SANCHAIE/mongobox/docs/MangoBox_Handout.docx

ใบงานเวิร์กช็อป

MangoBox — วัดแก๊สเอทิลีน และพิสูจน์ว่าเอทิลีนเร่งการสุก

การประดิษฐ์วงจรบอร์ดเซ็นเซอร์เพื่อดูดซับแก๊สเอทิลีน · ระบบปิด · เหตุ (แก๊ส) → ผล (การสุก)

ชื่อ–สกุล ผู้ทำใบงาน: | ทีม/กลุ่ม:
วันที่: 13 กรกฎาคม 2569 | โรงเรียน: พลูตาหลวงวิทยา

# 1. จุดประสงค์การเรียนรู้

- อธิบายได้ว่าเอทิลีนคืออะไร และเป็น "ตัวเร่ง" การสุกของผลไม้อย่างไร
- ต่อวงจร ESP32-S3 เข้ากับเซ็นเซอร์ SGP30, TCS34725, BME280 และจอ OLED บนบัส I2C ได้
- แยกได้ว่าอะไรคือ "เหตุ" (ระดับเอทิลีน) และอะไรคือ "ผล" (อัตราการสุก)
- ออกแบบการทดลองเปรียบเทียบ 4 กล่อง พิสูจน์ว่าเอทิลีนเร่งการสุกจริง และนำเสนอผลได้
- ใช้กล่องได้ 2 โหมด: METER (คัดผลไม้ใช้จริง) และ LAB (ทดลองพิสูจน์เหตุ–ผล)

# 2. อุปกรณ์ต่อ 1 ชุด

อุปกรณ์ | หน้าที่ | I2C Address
บอร์ด ESP32-S3 N16R8 (DevKitC-1) | ตัวประมวลผล + WiFi/BT | -
SGP30 | เซ็นเซอร์แก๊ส (TVOC + eCO2) | 0x58
TCS34725 | เซ็นเซอร์สีเปลือก (RGB) | 0x29
BME280 | อุณหภูมิ / ความชื้น | 0x76 หรือ 0x77
จอ OLED SSD1306 0.96" | แสดงผลค่าเรียลไทม์ | 0x3C
พัดลม 5V + ทรานซิสเตอร์ | กวนอากาศในกล่อง | -
เบรดบอร์ด + สายจัมเปอร์ | ต่อวงจร | -
กล่อง/ถุงพลาสติกใส | ห้องปิด (chamber) | -

# 3. การต่อวงจร (Wiring)

หลักการสำคัญ: เซ็นเซอร์และจอทุกตัวใช้บัส I2C ร่วมกัน จึงต่อ 4 สายเหมือนกันทุกตัว โดยใช้รางไฟบวก (+) และราง GND (–) บนเบรดบอร์ดช่วย

ขาของเซ็นเซอร์/จอ | ต่อเข้ากับ ESP32 | สี/หมายเหตุ
VCC | 3V3 | ไฟเลี้ยง (แดง)
GND | GND | กราวด์ (ดำ)
SDA | GPIO8 | สายข้อมูล (น้ำเงิน)
SCL | GPIO9 | สายนาฬิกา (เขียว)
พัดลม (สายคุม) | GPIO10 | ผ่านทรานซิสเตอร์เท่านั้น

ดูรายละเอียดจาก "แผนผังการต่อวงจร (wiring_diagram)" ที่แจกคู่กับใบงานนี้

⚠ ข้อควรระวัง

ต่อสายให้เสร็จก่อนเสียบ USB ทุกครั้ง และตรวจว่า VCC/GND ไม่สลับกัน

พัดลมกินไฟมาก ห้ามต่อขาพัดลมกับ GPIO โดยตรง ต้องผ่านทรานซิสเตอร์เสมอ

# 4. สองโหมดในกล่องเดียว (ใช้ปุ่ม BOOT บนบอร์ด — ไม่ต้องต่อปุ่มเพิ่ม)

| โหมด METER (ใช้งานจริง) | โหมด LAB (ทำโครงงาน)
ตอบคำถาม | "มะม่วงลูกนี้กินได้หรือยัง?" | "เอทิลีนเร่งการสุกจริงไหม?"
จอแสดงผล | ความสุกรวม 0–100% + ดิบ/พอดี/งอม | ETHYLENE | RIPE แยกช่อง + อัตราการสุก
การรวมค่า | รวมสี 60% + แก๊ส 40% | ไม่รวม — แยกเหตุกับผลเด็ดขาด
ใช้ตอน | คัดผลไม้ ตรวจก่อนกิน/ก่อนส่ง | ทดลอง 4 กล่อง เก็บข้อมูลข้ามวัน

วิธีใช้ปุ่ม BOOT (ปุ่มสีดำเล็ก ๆ ที่ติดมากับบอร์ดแล้ว)

กดค้าง 2 วินาที = สลับโหมด (จอจะขึ้น SWITCH MODE)

กดสั้น ๆ 1 ครั้ง = บันทึกผลประจำวัน (ใช้เฉพาะโหมด LAB)

ห้ามกดปุ่มนี้ค้างไว้ตอนกด RESET หรือตอนเสียบสาย USB (บอร์ดจะเข้าโหมดอัปโหลด)

วางบอร์ดไว้นอกกล่อง เพื่อกดปุ่มได้โดยไม่ต้องเปิดฝา (เปิดฝา = แก๊สหนีหมด)

# 5. บันได 10 ขั้น — ทำทีละขั้น ติ๊กเมื่อผ่าน

อย่าข้ามขั้น! ถ้าขั้นก่อนหน้ายังไม่ผ่าน ขั้นถัดไปจะพังแน่นอน และหาสาเหตุยากขึ้นเรื่อย ๆ

✓ | ขั้น | สิ่งที่ได้เรียนรู้ | ผ่านเมื่อ...
| 1. RGB LED + Serial | setup / loop / Serial | ไฟ RGB (GPIO48) ไล่สี + Serial มีข้อความ
| 2. I2C Scan | บัส I2C, address, การเช็ก ACK | เจอครบ 4 ตัว: 0x29 0x3C 0x58 0x76 (นิ่ง 20/20)
| 3. BME280 | ไลบรารี, อ่านค่าเซ็นเซอร์ | เห็นอุณหภูมิ/ความชื้น
| 4. OLED | วาดบนจอ, พิกัด x/y | จอโชว์อุณหภูมิตัวใหญ่
| 5. เซ็นเซอร์สี | RGB → Hue, เขียนฟังก์ชันเอง | จ่อใบไม้ = %ต่ำ / ของเหลือง = %สูง
| 6. เซ็นเซอร์แก๊ส ★ | TVOC, อุ่นเครื่อง, ชดเชยความชื้น | ปิดกล่องมีกล้วย → ตัวเลขไต่ขึ้น!
| 7. พัดลม | ทรานซิสเตอร์เป็นสวิตช์ | พัดลมหมุน 3 วิ หยุด 3 วิ
| 8. METER ★ | ถ่วงน้ำหนัก, ตัดสินใจจากข้อมูล | เครื่องวัดความสุกใช้ได้จริง
| 9. โหมด LAB | ตัวแปรต้น–ตาม, บันทึกข้ามวัน | แยกเหตุ-ผล + กดปุ่มบันทึกได้
| 10. WiFi Dashboard | web server, JSON | เปิดดูค่าบนมือถือได้

★ = ขั้นที่ห้ามข้ามเด็ดขาด

STEP 6 (แก๊ส) — เป็นขั้นเดียวที่เรา "เห็นกับตา" ว่าผลไม้ปล่อยแก๊สจริง ถ้าข้าม โปรเจกต์จะเหลือแค่ "วัดสี" ซึ่งไม่ตรงโจทย์

STEP 8 (METER) — เป็นขั้นที่ทุกอย่างมารวมกันเป็นเครื่องมือใช้จริง

ทุกไฟล์โค้ดมีหัวข้อ "ลองเล่นดู" และ "คำถาม" อยู่ท้ายไฟล์ — ตรงนั้นคือจุดที่เราจะเข้าใจจริง ไม่ใช่ตอนก๊อปโค้ด

# 6. ขั้นตอนการทดลอง

1. ต่อวงจรตามตารางข้อ 3 และตรวจสอบสายให้เรียบร้อย
2. เปิด Arduino IDE เลือกบอร์ด ESP32S3 Dev Module → เปิด USB CDC On Boot: Enabled แล้วเลือกพอร์ตให้ถูกต้อง
3. เปิดไฟล์ mango_ripeness_esp32.ino แก้บรรทัด #define BOX_ID ให้ตรงกับกล่องของกลุ่ม (A/B/C/D) แล้วกด Upload
4. เปิด Serial Monitor (115200) ตรวจว่าเจอเซ็นเซอร์ครบ — ถ้าเจอบ้างไม่เจอบ้าง = สายหลวม ให้รัน tools/i2c_stability เช็ก 20 รอบ

PART A — วันนี้ในเวิร์กช็อป

5. โหมด METER: เอาเซ็นเซอร์สีจ่อมะม่วงหลาย ๆ ลูก อ่านคะแนนความสุก แล้วลองคัดว่าลูกไหน ดิบ/พอดี/งอม
6. จัดกล่องตามที่ได้รับมอบหมาย ปิดฝา เปิดพัดลม รอ SGP30 อุ่นเครื่อง (15 วินาทีแรกค่าจะขึ้น 0 ppb เป็นเรื่องปกติ)
7. กดปุ่ม BOOT ค้าง 2 วินาที เพื่อสลับไปโหมด LAB
8. บันทึกค่า TVOC ทุก 5 นาที ลงตาราง 7.1 (วันนี้จะเห็น TVOC พุ่งขึ้นภายใน 10–20 นาที)

PART B — ต่อเนื่อง 3–5 วันก่อนแข่ง

9. กดปุ่ม BOOT สั้น ๆ 1 ครั้ง = บันทึกผลประจำวัน (ทำวันละครั้ง เวลาเดิม ต่อเนื่อง 3–5 วัน)
10. วันสุดท้าย พิมพ์ตัวอักษร p ใน Serial Monitor เพื่อดูตารางสรุปทั้งหมด แล้วกรอกลงตาราง 7.2

กล่องของแต่ละกลุ่ม (เขียนวงกลมรอบกล่องของกลุ่มตัวเอง)

A = มะม่วง + กล้วยสุกงอม (เพิ่มเอทิลีน → คาดว่าสุกเร็วที่สุด)

B = มะม่วงอย่างเดียว (control / ตัวเทียบ)

C = มะม่วง + ด่างทับทิม (ดูดซับเอทิลีน → คาดว่าสุกช้าที่สุด)

D = กล่องเปล่า (baseline ของเซ็นเซอร์)

# 7. ตารางบันทึกผล

7.1 วันนี้: ดู "เหตุ" — เอทิลีนพุ่งขึ้นไหม? (บันทึกทุก 5 นาที)

กล่องของกลุ่ม: ............ สิ่งที่ใส่ในกล่อง: ..............................................................

ครั้งที่ | เวลา | อุณหภูมิ (°C) | ความชื้น (%) | TVOC (ppb) | ความสุกจากสี (%)
1
2
3
4
5
6

สังเกต: วันนี้ "สี" จะยังแทบไม่เปลี่ยน — เพราะการสุกต้องใช้เวลาหลายวัน นั่นคือเหตุผลที่ต้องเก็บข้อมูลต่อ

7.2 หลายวัน: ดู "ผล" — กล่องไหนสุกเร็วกว่ากัน? (กดปุ่ม BOOT วันละครั้ง)

วันที่ | กล่อง A (กล้วย) | กล่อง B (control) | กล่อง C (ดูดซับ) | กล่อง D (เปล่า)
TVOC / ความสุก (%) | TVOC / ความสุก | TVOC / ความสุก | TVOC / ความสุก | TVOC / ความสุก
วัน 1
วัน 2
วัน 3
วัน 4
วัน 5

7.3 สรุป: อัตราการสุก (%/วัน)

อัตราการสุก = (ความสุกวันสุดท้าย − ความสุกวันแรก) ÷ จำนวนวันที่ผ่านไป

กล่อง | TVOC เฉลี่ย (ppb) | อัตราการสุก (%/วัน) | เรียงลำดับการสุก (เร็ว→ช้า)
A (กล้วยสุกงอม)
B (control)
C (ด่างทับทิม)
D (กล่องเปล่า)

# 8. วาดกราฟความสัมพันธ์ (เหตุ → ผล)

เอาข้อมูลจากตาราง 7.3 มาลงจุด แกนนอน = TVOC (ppb), แกนตั้ง = อัตราการสุก แล้วเขียนชื่อกล่อง (A/B/C/D) กำกับแต่ละจุด

อัตราการสุก (%/วัน) ↑

TVOC (ppb) — พร็อกซี่ของเอทิลีน →

ถ้าจุดเรียงจากล่างซ้ายไปบนขวา = แก๊สยิ่งสูง การสุกยิ่งเร็ว → สมมติฐานเป็นจริง!

# 9. คำถามท้ายการทดลอง

1) ในระบบนี้ อะไรคือ "เหตุ" และอะไรคือ "ผล"? เราวัดแต่ละอย่างด้วยเซ็นเซอร์ตัวไหน?
2) ทำไมเราจึง "ไม่" เอาค่าแก๊สกับค่าสีมารวมเป็นคะแนนเดียวกัน?
3) กล่อง D (เปล่า) ไม่มีผลไม้เลย แล้วเรามีไว้ทำไม?
4) ด่างทับทิมทำให้เอทิลีนลดลงจริงไหม? ดูจากตัวเลขใด และการสุกช้าลงตามไปด้วยหรือไม่?

# 10. สรุปผลและข้อจำกัด

สมมติฐานของเรา: กล่องที่มีเอทิลีนสูงกว่า จะสุกเร็วกว่า

ผลการทดลองสนับสนุนสมมติฐานหรือไม่ (วงกลม): สนับสนุน / ไม่สนับสนุน / ยังสรุปไม่ได้

เพราะ ............................................................................................................................

ข้อจำกัดที่ต้องเขียนในรายงาน (กรรมการชอบทีมที่บอกข้อจำกัดตัวเองได้)

SGP30 วัด "สารระเหยรวม (TVOC)" ไม่ใช่เอทิลีนบริสุทธิ์ จึงเป็นเพียงตัวแทน (พร็อกซี่) ของเอทิลีน

eCO2 ที่เซ็นเซอร์ให้มา เป็นค่า "ประมาณ" ไม่ใช่ CO₂ ที่วัดจริง — ห้ามเคลมเกินในรายงาน

สิ่งที่เชื่อถือได้คือการ "เปรียบเทียบระหว่างกล่อง" ไม่ใช่ตัวเลขสัมบูรณ์

ตัวแปรอื่นที่อาจรบกวน: อุณหภูมิ ความชื้น ความสุกเริ่มต้นของมะม่วงแต่ละลูก

# 11. ต่อยอด: เอาผลจาก LAB ไปคาลิเบรต METER

นี่คือจุดที่ทำให้โปรเจกต์นี้โตกว่างานประกวดทั่วไป — เราไม่ได้ "เดา" เกณฑ์ แต่ทดลองหาเกณฑ์เอง แล้วเอาไปทำเป็นเครื่องมือใช้จริง

ค่าในโค้ด | ความหมาย | ค่าเริ่มต้น | ค่าที่วัดได้จริง
HUE_RAW | สีตอนดิบ (0%) | 120°
HUE_RIPE | สีตอนสุกพอดี (100%) | 55°
TVOC_BASE | TVOC อากาศสะอาด (ppb) | 0
TVOC_HIGH | TVOC ตอนสุกเต็มที่ (ppb) | 500

วิธีทำ: ดูจากข้อมูลหลายวันว่ามะม่วงที่ "สุกพอดีกินได้" มีค่า Hue เท่าไร แล้วนำไปแก้ค่าในไฟล์ .ino จากนั้นโหมด METER จะแม่นขึ้นสำหรับมะม่วงพันธุ์นี้โดยเฉพาะ

# 12. ไล่บั๊ก: เจอปัญหาแบบนี้ ทำยังไง

ตารางนี้มาจากการทดสอบจริง — ปัญหาพวกนี้จะเจอแน่นอน ไม่ใช่เรื่องแปลก

อาการ | สาเหตุที่เป็นไปได้ | วิธีแก้
Serial Monitor เงียบสนิท ไม่มีข้อความเลย | USB CDC On Boot ยังไม่เปิด | Tools → USB CDC On Boot → Enabled แล้วอัปโหลดใหม่
ไฟ RGB ไม่ติด | ขาผิด (บอร์ดนี้ใช้ GPIO48 ไม่ใช่ 38) | เปลี่ยนเป็น 48 และใช้ neopixelWrite() ไม่ใช่ digitalWrite()
I2C Scan ไม่เจออะไรเลย (0 ตัว) | SDA/SCL สลับกัน หรือไม่มี ไฟเลี้ยง | เช็ก SDA→GPIO8, SCL→GPIO9 และ VCC→3V3, GND→GND
เจอบ้าง ไม่เจอบ้าง สลับไปมา | สายหลวม (ปัญหาอันดับ 1!) | กดสายให้แน่น ใช้สายสั้นลง ลดจุดต่อ + Wire.setClock(50000)
ไม่เจอจอ OLED แต่สายต่อถูกแล้ว | จอบางรุ่นใช้ address 0x3D ไม่ใช่ 0x3C | ดูผลสแกนว่ามี 0x3D ไหม แล้วแก้ในโค้ด
ไม่เจอ SGP30 (0x58) | บางโมดูลต้องการไฟ 5V ไม่ใช่ 3V3 | ย้าย VCC ของ SGP30 ไปที่ 5V
โปรแกรมบอก OK แต่จอดำสนิท | begin() ของไลบรารีโกหก! | ใช้ i2cAlive() เช็ก ACK เอง ก่อนเรียก begin()
Adafruit_Sensor.h not found | ชื่อไลบรารีไม่ตรงชื่อไฟล์ | ค้นว่า "Adafruit Unified Sensor" ใน Library Manager
TVOC ค้างที่ 0 ppb | SGP30 กำลังอุ่นเครื่อง | รอ 15 วินาที (ปกติ) ถ้าเกินนั้น = เช็กสาย
TVOC สูงผิดปกติ ทั้งที่ไม่มีผลไม้ | ฟลักซ์บัดกรียังไม่ล้าง หรือยังไม่ burn-in | ล้างฟลักซ์ด้วย IPA + เสียบไฟทิ้งไว้ให้นานที่สุด

บทเรียนวิศวกรรมที่สำคัญที่สุด

"อย่าเชื่อสิ่งที่คนอื่นเขียนมา — ตรวจสอบเอง"

เราพบว่า SSD1306.begin() คืนค่า "สำเร็จ" ทั้งที่ไม่ได้ต่อจอเลย! เพราะมันไม่ได้เช็กว่ามีใครตอบกลับมาจริงไหม

วิศวกรที่ดีจะไม่เชื่อคำตอบง่าย ๆ แต่จะหาวิธีตรวจสอบที่เชื่อถือได้ (ในที่นี้คือเช็ก I2C ACK เอง)

ถ้ากลุ่มไหนเซ็นเซอร์เสีย ไม่ต้องกังวล — ใช้ MOCK MODE (step00_mock) เรียนต่อได้ทันที

หมายเหตุด้านความปลอดภัย: ด่างทับทิม (KMnO₄) เป็นสารออกซิไดซ์ ควรให้ครูผู้ดูแลเป็นผู้หยิบจับ และล้างมือหลังการทดลองทุกครั้ง
