SANCHAIE/mongobox/docs/MangoBox_Workshop_Slides.pptx

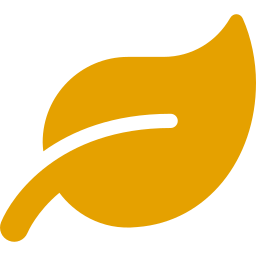
[picture p1: figure]

WORKSHOP · ESP32 · 6 ชั่วโมง

MangoBox

วัดแก๊สเอทิลีน และพิสูจน์ว่าเอทิลีนเร่งการสุกของผลไม้

เครื่องวัดความสุกใช้จริง (METER) + ชุดทดลองพิสูจน์เหตุ–ผล (LAB) ในบอร์ดเดียว

วิทยากร ผศ.ดร.สัญชัย เอียดปราบ (ESCE, คณะวิศวกรรมศาสตร์ ม.บูรพา)

ผู้เข้าอบรม ครูและนักเรียน โรงเรียนพลูตาหลวงวิทยา (ทีมแพรกษาวิชาการ ครั้งที่ 31)

วันที่ วันจันทร์ที่ 13 กรกฎาคม 2569 ณ คณะวิศวกรรมศาสตร์ มหาวิทยาลัยบูรพา

## Slide 2

ภาพรวม

วันนี้เราจะได้สร้างและเข้าใจอะไรบ้าง

ประกอบ "กล่องวัดเอทิลีน"

ระบบปิดที่วัดระดับแก๊สเอทิลีนได้จริง ด้วย ESP32-S3 + เซ็นเซอร์ 3 ตัว

เข้าใจ "เอทิลีน"

ฮอร์โมนแก๊สที่ "เร่ง" ให้ผลไม้สุก และวิธีวัดด้วยเซ็นเซอร์แก๊ส SGP30 (TVOC)

ใช้จริง + ทำโครงงาน

โหมด METER คัดผลไม้ได้ทันที · โหมด LAB ทดลอง 4 กล่องพิสูจน์เหตุ–ผล

เก็บข้อมูล + นำเสนอ

บันทึกหลายวัน พล็อตกราฟความสัมพันธ์ พร้อมไปแข่งแพรกษาวิชาการ

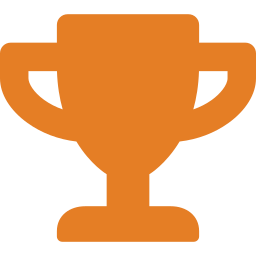
[picture p2: figure]

## Slide 3

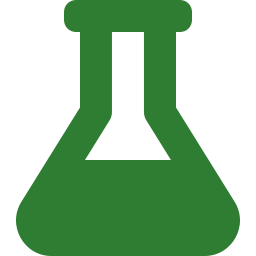
[picture p3: figure]

วิทยาศาสตร์เบื้องหลัง

เอทิลีน — "ฮอร์โมนการสุก" ของผลไม้

เกิดอะไรขึ้นเมื่อผลไม้สุก?

- ผลไม้ปล่อยแก๊ส เอทิลีน (C₂H₄) ออกมาเอง
- เอทิลีนเป็นตัวเร่ง/สั่งให้ผลไม้สุกต่อ — ยิ่งสุกยิ่งปล่อยมาก (autocatalytic)
- พร้อมกันนั้น แป้ง → น้ำตาล, เปลือกเปลี่ยนสี เขียว → เหลือง, เนื้อนิ่มลง
- "ผลไม้ 1 ลูกสุก ทำให้ลูกข้าง ๆ สุกตาม" คือเอทิลีนกำลังทำงาน

เราวัดอะไรได้บ้าง?

กลิ่น/แก๊สที่ระเหย

→ SGP30 (TVOC, ppb)

สีเปลือกที่เปลี่ยน

→ เซ็นเซอร์สี (TCS34725)

อุณหภูมิ/ความชื้น

→ BME280 (ตัวแปรร่วม)

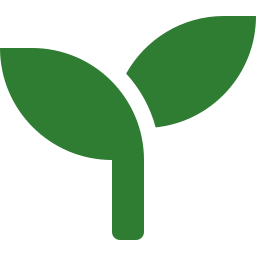
[picture p4: figure]
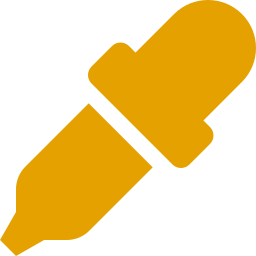
[picture p5: figure]
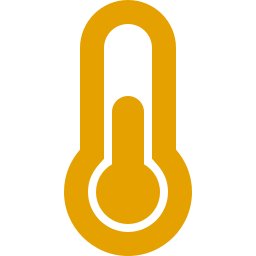
[picture p6: figure]

## Slide 4

หัวใจของการทดลอง

ทำไมต้องเป็น "ระบบปิด" (Closed Chamber)?

ปัญหา

- เอทิลีนจากมะม่วง 1 ลูกมีปริมาณน้อยมาก
- ถ้าวัดในที่โล่ง แก๊สจะฟุ้งหายไปทันที
- เซ็นเซอร์แทบจับความเปลี่ยนแปลงไม่ได้

วิธีแก้: ขังแก๊สให้เข้มข้นขึ้น

ขังในกล่อง/ถุงพลาสติกใส

แก๊สสะสมเข้มข้นขึ้นเรื่อย ๆ วัดค่าความต่างได้ชัด

ใส่พัดลมจิ๋วกวนอากาศ

ค่าเซ็นเซอร์นิ่งและสม่ำเสมอทั่วทั้งกล่อง

เทียบกับ "กล่องเปล่า" (control)

เห็นชัดว่าค่าที่สูงขึ้นมาจากผลไม้จริง

เพิ่มสารดูดซับเอทิลีน (KMnO₄)

ทดลองได้ว่าตัวดูดซับช่วยชะลอการสุกจริงไหม

1

2

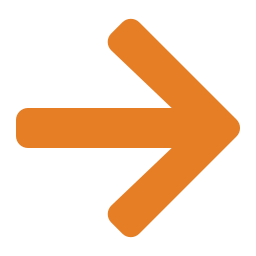
[picture p7: figure]

3

4

## Slide 5

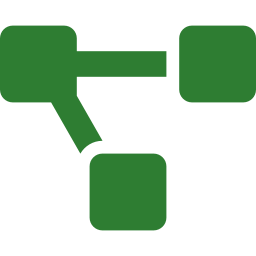
[picture p8: figure]

สถาปัตยกรรมระบบ

ภาพรวมระบบ: เซ็นเซอร์ → สมอง → แสดงผล

SGP30

แก๊ส TVOC (ppb)

จอ OLED

แสดงค่า real-time

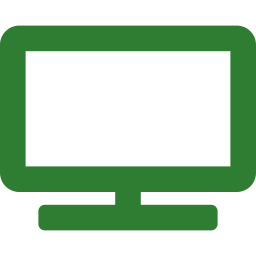
[picture p9: figure]

ESP32-S3

อ่านค่า · คำนวณ · WiFi

TCS34725

สีเปลือก

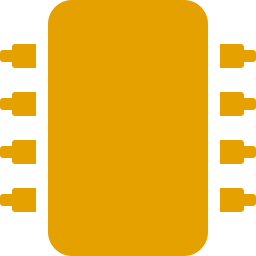
[picture p10: figure]

Serial Plotter

กราฟ + บันทึก CSV

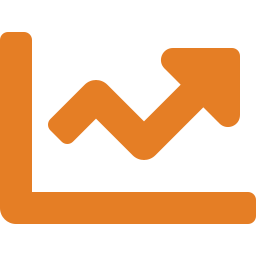
[picture p11: figure]

BME280

อุณหภูมิ/ชื้น

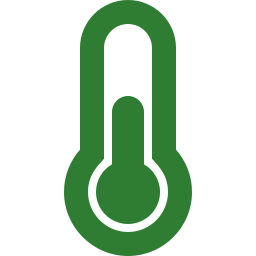
[picture p12: figure]

Dashboard WiFi

ดูจากมือถือ

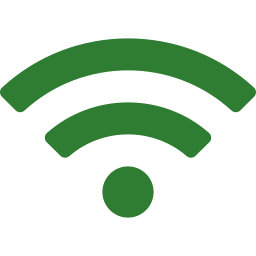
[picture p13: figure]

I2C bus

## Slide 6

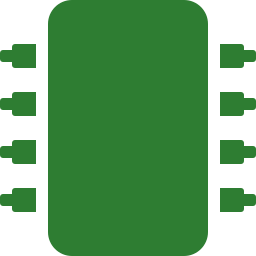
[picture p14: figure]

อุปกรณ์

ทำความรู้จักเซ็นเซอร์ในกล่อง

SGP30

แก๊ส TVOC

วัดสารระเหยรวม (พร็อกซี่ของเอทิลีน) เป็น ppb + eCO2

TCS34725

เซ็นเซอร์สี

อ่านค่า RGB ของเปลือก — ช่องทางที่ชัวร์ที่สุด

I2C 0x58

I2C 0x29

BME280

อุณหภูมิ/ชื้น

ใช้ชดเชยค่าแก๊สให้แม่นขึ้น + เป็นตัวแปรร่วม

OLED 0.96"

จอแสดงผล

SSD1306 แสดงค่าและแถบความสุกแบบเรียลไทม์

I2C 0x76

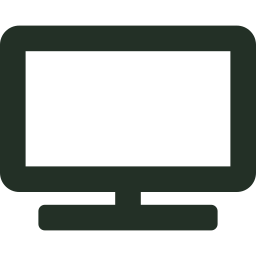
[picture p15: figure]

I2C 0x3C

## Slide 7

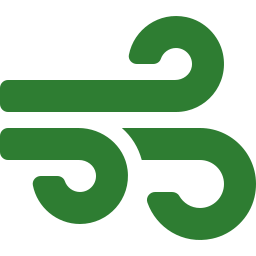
[picture p16: figure]

เจาะลึกเซ็นเซอร์แก๊ส

SGP30 กับค่า "TVOC (ppb)" ที่ต้องเข้าใจ

SGP30 ให้ค่าอะไร

- TVOC (ppb)
  - ปริมาณสารระเหยรวมในอากาศ — อากาศสะอาด ≈ 0 ppb
  - ผลไม้สุกปล่อยสารระเหยมาก → ตัวเลขยิ่งสูง
- eCO2 (ppm) — ของแถม
  - เป็นค่า "ประมาณ" จากไฮโดรเจน ไม่ใช่ CO₂ จริง

ข้อควรระวัง (สำคัญมาก)

- อุ่นเครื่อง 15 วินาที
  - ช่วงแรกจะขึ้น 0 ppb เสมอ — เป็นเรื่องปกติ
- ต้องมี Baseline ถึงจะแม่น
  - โปรแกรมเก็บ/คืนค่าให้อัตโนมัติ (ทุก 1 ชม.)
  - ครั้งแรกควรเสียบทิ้งไว้ ~12 ชม. (burn-in)

## Slide 8

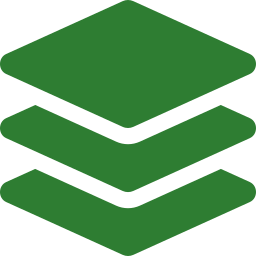
[picture p17: figure]

หัวใจของโปรเจกต์

แยก "เหตุ" ออกจาก "ผล" — ห้ามรวมกัน!

เราจะพิสูจน์ว่า เอทิลีน (เหตุ) เป็นตัวเร่งการสุก (ผล) จึงต้องวัดสองอย่างนี้แยกกันเป็นคนละค่า

เหตุ

ตัวแปรต้น

- ระดับแก๊สเอทิลีน
- วัดด้วย SGP30 → TVOC (ppb)
- ยิ่งมีเอทิลีนมาก ค่ายิ่งสูง

ผล

ตัวแปรตาม

- อัตราการสุก (%/วัน)
- วัดด้วย TCS34725 → สีเปลี่ยนเร็วแค่ไหน
- ไม่ใช่ "ความสุก ณ จุดเดียว"

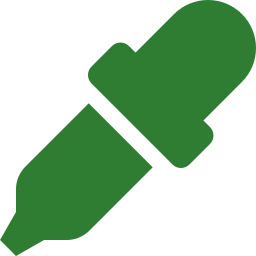
[picture p18: figure]

เร่งให้เกิด

ถ้าเอาสีกับแก๊สมารวมเป็นคะแนนเดียว = เอา "เหตุ" ปนกับ "ผล" แล้วจะพิสูจน์ความสัมพันธ์ไม่ได้เลย

## Slide 9

หนึ่งกล่อง สองการใช้งาน

โหมด METER (ใช้จริง) และโหมด LAB (โครงงาน)

เซ็นเซอร์ชุดเดียวกัน ข้อมูลชุดเดียวกัน — ต่างกันแค่ "จะเอาไปตอบคำถามอะไร"

"มะม่วงลูกนี้กินได้หรือยัง?"

- รวมสี (60%) + แก๊ส (40%) เป็นคะแนนเดียว
- จอโชว์: ความสุก 0–100% + ดิบ / พอดี / งอม
- ใช้คัดผลไม้ ตรวจก่อนกิน / ก่อนส่งขาย

METER

เอาไปใช้จริง

"เอทิลีนเร่งการสุกจริงไหม?"

- แยกเหตุ (เอทิลีน) กับ ผล (การสุก) — ไม่รวมกัน
- จอโชว์: ETHYLENE | RIPE + อัตราการสุก
- ใช้ทดลอง 4 กล่อง เก็บข้อมูลข้ามวัน

LAB

ทำโครงงาน

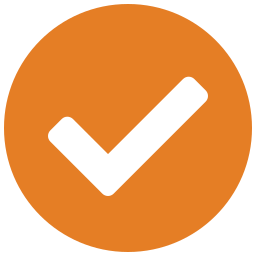
[picture p19: figure]
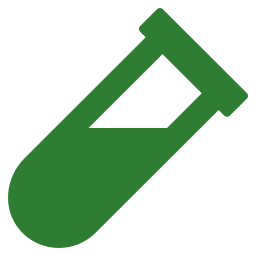
[picture p20: figure]

สลับโหมด: กดปุ่ม BOOT ค้าง 2 วินาที (ปุ่มนี้มีอยู่บนบอร์ดแล้ว ไม่ต้องต่อเพิ่ม) · CSV ส่งออกครบทุกคอลัมน์เสมอ ไม่ว่าอยู่โหมดไหน

## Slide 10

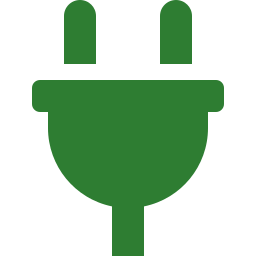
[picture p21: figure]

การเชื่อมต่อ

I2C: สายสองเส้น ใช้ร่วมกันทุกตัว

ทำไม I2C สะดวก

- ใช้แค่ 2 สายข้อมูล: SDA และ SCL
- อุปกรณ์ทุกตัวต่อขนานบนสายเดียวกัน
- แยกกันด้วย "ที่อยู่ (address)" ที่ไม่ซ้ำ
- เพิ่มเซ็นเซอร์ได้ง่าย ไม่ต้องเดินสายใหม่
- ESP32-S3: SDA = GPIO8, SCL = GPIO9

ที่อยู่ (address) ของแต่ละตัว

อุปกรณ์ | หน้าที่ | Address
TCS34725 | สี | 0x29
OLED | จอ | 0x3C
SGP30 | แก๊ส | 0x58
BME280 | อุณหภูมิ/ชื้น | 0x76/0x77

ถ้าตัวไหนหาไม่เจอ ใช้สเก็ตช์ i2c_scanner เช็กสายได้

## Slide 11

ลงมือต่อวงจร

การต่อสาย: ราง (+)/(–) และบัส I2C

SGP30

TCS

BME

ตารางต่อสาย (สรุป)

ขาเซ็นเซอร์ | → ESP32
VCC | 3V3
GND | GND
SDA | GPIO8
SCL | GPIO9
พัดลม (คุม) | GPIO10*

* พัดลมต่อผ่านทรานซิสเตอร์ ไม่ต่อกับ GPIO ตรง ๆ

ESP32-S3

3V3

GND

SDA (8)

SCL (9)

เซ็นเซอร์ทุกตัวต่อ 4 สายเหมือนกัน: VCC→3V3, GND→GND, SDA→GPIO8, SCL→GPIO9

## Slide 12

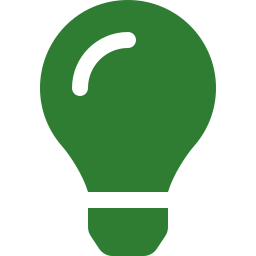
[picture p22: figure]

จากการทดสอบจริง

5 กับดักที่จะเจอแน่นอน — รู้ไว้ก่อน

ทั้งหมดนี้เจอจริงตอนทดสอบ ไม่ใช่ทฤษฎี — เตรียมใจไว้ จะไม่เสียเวลาหน้างาน

USB CDC On Boot = Enabled

ถ้าไม่เปิด → Serial Monitor เงียบสนิท
(เจอบ่อยสุด นักเรียนจะนึกว่าโค้ดพัง)

1

RGB LED อยู่ GPIO48 ไม่ใช่ 38

บอร์ดโคลนย้ายขา และต้องใช้
neopixelWrite() ไม่ใช่ digitalWrite()

2

อย่าเชื่อ begin() — โกหกได้!

SSD1306.begin() คืน true ทั้งที่ไม่ได้ต่อจอ
→ ต้องเช็ก I2C ACK เอง

3

ชื่อไลบรารี ≠ ชื่อไฟล์ .h

Adafruit_Sensor.h ต้องค้นว่า
"Adafruit Unified Sensor"

4

สายหลวม = ปัญหาอันดับ 1

อาการ: เจอบ้างไม่เจอบ้าง
→ Wire.setClock(50000) ช่วยได้เยอะ

บทเรียนวิศวกรรมที่สำคัญที่สุดของวันนี้

"อย่าเชื่อสิ่งที่คนอื่นเขียนมา — ตรวจสอบเอง"
ไลบรารีบอกว่า OK ไม่ได้แปลว่ามันทำงานจริง — วิศวกรที่ดีตรวจสอบด้วยตัวเองเสมอ

5

## Slide 13

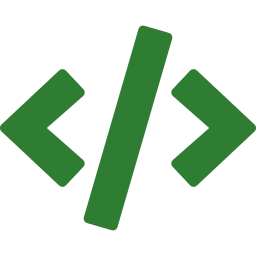
[picture p23: figure]

วิธีเรียนวันนี้

สร้างทีละชั้น — ไม่ใช่แจกโค้ดก้อนเดียว

แต่ละขั้นเพิ่มของใหม่ทีละอย่าง ทดสอบให้ผ่านก่อน แล้วค่อยไปขั้นถัดไป

Blink

บอร์ดไหว

1

I2C Scan

เจอเซ็นเซอร์

2

BME280

อุณหภูมิ/ชื้น

3

OLED

มีจอแล้ว

4

สี

→ %ความสุก

5

แก๊ส

เห็นเอทิลีนพุ่ง!

6

พัดลม

สั่งงานจริง

7

METER

รวมร่าง

8

LAB

แยกเหตุ-ผล

9

WiFi

ดูบนมือถือ

10

ห้ามข้าม STEP 6 — เป็นขั้นเดียวที่นักเรียน "เห็นกับตา" ว่าผลไม้ปล่อยแก๊สจริง · ทุกไฟล์มี "ลองเล่นดู" + คำถามท้ายโค้ด

## Slide 14

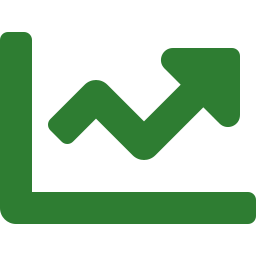
[picture p24: figure]

หัวใจของอัลกอริทึม

วัด "อัตราการสุก" ไม่ใช่ความสุก ณ จุดเดียว

อัตราการสุก (%/วัน) = ความสุกที่เพิ่มขึ้น (จากสี) ÷ จำนวนวันที่ผ่านไป

ความสุกจากสี (ใช้สีล้วน ๆ)

- แปลง RGB → Hue (องศาสี)
- เขียว (~120°) = ดิบ 0%
- เหลือง (~55°) = สุก 100%
- ไม่เอาค่าแก๊สมาปน เพราะแก๊สคือ "เหตุ"

สิ่งที่เราต้องการเห็น

ระดับเอทิลีน →

A มีเอทิลีนสูงสุด → สุกเร็วสุด | C ถูกดูดซับ → สุกช้าสุด

A

B

อัตราการสุก

C

## Slide 15

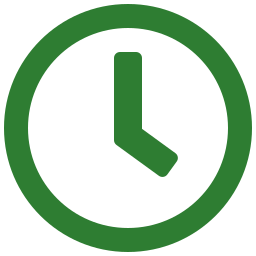
[picture p25: figure]

แผนการอบรม

กำหนดการ 6 ชั่วโมง (09:00 – 16:00)

เวลา | กิจกรรม
09:00–09:30 | วิทยาศาสตร์: เอทิลีนเร่งการสุก + ระบบปิด + ภาพรวมบันได 10 ขั้น + กับดัก 5 ข้อ
09:30–10:15 | STEP 1–2: ตั้งค่า IDE (USB CDC + PSRAM!), RGB LED, I2C Scan — ต้องเจอครบ 4 ตัว
10:15–11:00 | STEP 3–4: อ่าน BME280 → แสดงผลบนจอ OLED
11:00–12:00 | STEP 5: เซ็นเซอร์สี → คำนวณ %ความสุกด้วยตัวเอง (Hue)
12:00–13:00 | พักกลางวัน (เตรียมกล่องกล้วยสุกไว้ให้แก๊สสะสม)
13:00–13:50 | STEP 6: วัดแก๊ส! ปิดกล่อง → เห็น TVOC ไต่ขึ้นกับตา (ห้ามข้าม)
13:50–14:20 | STEP 7: พัดลม + ทรานซิสเตอร์ (สั่งงานโลกจริง)
14:20–15:00 | STEP 8: รวมร่างเป็นเครื่องวัดความสุก แล้วลองวัดมะม่วงจริง
15:00–15:40 | STEP 9–10: โหมด LAB (แยกเหตุ-ผล) + WiFi Dashboard
15:40–16:00 | จัดกล่อง A/B/C/D + วางแผนเก็บข้อมูล 3–5 วัน + ถาม-ตอบ

Core (ต้องเสร็จ): STEP 1–6 และ 8 · Stretch (ถ้าทัน): STEP 7, 9, 10 — ทำต่อที่โรงเรียนได้

## Slide 16

การทดลองหลัก

4 กล่อง พิสูจน์ว่า "เอทิลีนเร่งการสุก"

คำถามวิจัย: ถ้าเพิ่ม/ลดเอทิลีนในกล่อง มะม่วงจะสุกเร็วขึ้น/ช้าลงจริงไหม?

มะม่วง + กล้วยสุกงอม

เพิ่มเอทิลีน

เอทิลีนสูงสุด
→ สุกเร็วที่สุด

A

มะม่วงอย่างเดียว

control (ตัวเทียบ)

เอทิลีนปกติ
→ สุกปกติ

B

มะม่วง + KMnO₄

ดูดซับเอทิลีน

เอทิลีนต่ำสุด
→ สุกช้าที่สุด

C

กล่องเปล่า

baseline เซ็นเซอร์

ไม่มีเอทิลีน
→ ไม่มีการสุก

D

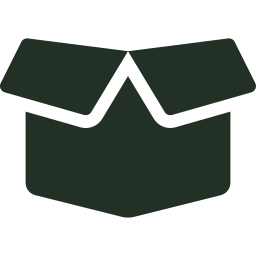
[picture p26: figure]

ถ้าได้ผล เอทิลีน: A > B > C และ อัตราการสุก: A > B > C ไปในทางเดียวกัน = พิสูจน์สำเร็จ

## Slide 17

วางแผนเก็บข้อมูล

แก๊สเห็นวันนี้ — แต่ "การสุก" ต้องรอหลายวัน

นี่คือจุดที่ทีมส่วนใหญ่พลาด: ถ้าเก็บข้อมูลแค่วันเดียว จะพิสูจน์ "อัตราการสุก" ไม่ได้

วันนี้ (13 ก.ค.)

ประกอบ + เห็นเอทิลีน
พุ่งใน 10–20 นาที

วัน 2–3

กดปุ่ม BOOT บันทึก
วันละครั้ง เวลาเดิม

วัน 4–5

สีเริ่มต่างกันชัด
ระหว่างกล่อง A/B/C

23–26 ก.ค.

แข่งแพรกษาวิชาการ
พร้อมกราฟหลายวัน

กติกาให้ข้อมูลน่าเชื่อถือ

- บันทึกเวลาเดิมทุกวัน (เช่น 09:00)
- วางกล่องที่เดิม อุณหภูมิใกล้เคียงกัน
- วัดสีจุดเดิมของผลเดิมทุกครั้ง

ข้อจำกัดที่ต้องเขียนในรายงาน

- SGP30 วัด "สารระเหยรวม (TVOC)" ไม่ใช่เอทิลีนเพียว ๆ — เป็นพร็อกซี่
- เชื่อการ "เปรียบเทียบระหว่างกล่อง" ไม่ใช่ตัวเลขสัมบูรณ์

กรรมการชอบทีมที่บอกข้อจำกัดตัวเองได้

## Slide 18

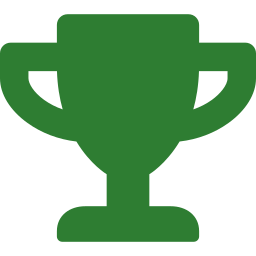
[picture p27: figure]

จุดขายของโปรเจกต์

ทำวิทยาศาสตร์ก่อน แล้วเอาผลไปสร้างเครื่องมือ

สองโหมดไม่ได้แยกกันอยู่ — มัน "ป้อนกันเอง" เป็นวงจร นี่คือเรื่องเล่าที่ทำให้โปรเจกต์โตกว่างานประกวดทั่วไป

โหมด LAB

ทดลอง 4 กล่อง เก็บข้อมูล
หลายวัน ได้กราฟเหตุ–ผล

คาลิเบรตเกณฑ์

รู้ว่ามะม่วงพันธุ์นี้
"สุกพอดี" ที่ Hue เท่าไร

โหมด METER

เครื่องวัดที่แม่นขึ้น
เพราะอิงข้อมูลจริง ไม่ใช่เดา

1

2

3

เก็บข้อมูลเพิ่ม → ปรับเกณฑ์ให้แม่นขึ้นอีก (วนซ้ำได้เรื่อย ๆ)

เล่ากับกรรมการว่า: "เราไม่ได้เดาเกณฑ์ เราทดลองหาเกณฑ์เอง แล้วเอาไปทำเป็นเครื่องมือใช้จริง"

## Slide 19

ต่อยอดสู่ AI

เพิ่มกล้อง + TinyML — และของลับที่เรามีอยู่แล้ว

จุดตายของโปรเจกต์ AI โรงเรียนทั่วไปคือ "การ label ข้อมูล" — เด็กต้องเดาเองว่ารูปไหนสุก ข้อมูลเลยมั่ว

แต่ MangoBox มีของที่คนอื่นไม่มี: เซ็นเซอร์บอกความสุกเป็นตัวเลขอยู่แล้ว → ถ่ายรูปพร้อมกัน = ข้อมูล "ติดป้ายตัวเองอัตโนมัติ"

เก็บชุดข้อมูล

กล้องถ่ายรูป + เซ็นเซอร์บอก
ความสุก % ในวินาทีเดียวกัน
→ ได้ข้อมูลติดป้ายฟรี

เทรนโมเดล

Edge Impulse: จำแนกภาพ
ดิบ / พอดี / งอม
(MobileNet 96×96)

ทำนายวันสุก

รวมภาพ (เห็นตอนนี้)
+ แก๊ส (บอกอนาคต)
→ "อีก 3 วันจะสุกพอดี"

1

2

3

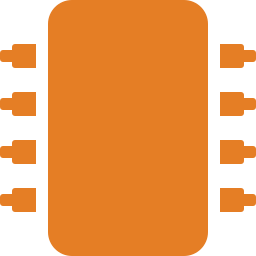
[picture p28: figure]

กล้องเห็นสี/รอยช้ำ/ผิวทั้งลูก แต่ "ดมกลิ่นไม่ได้" — แก๊สจึงยังจำเป็น เพราะบอกอนาคตที่ตายังไม่เห็น

## Slide 20

ถ้าจะทำจริง

ต้องใช้อะไร และพลาดตรงไหนบ่อยที่สุด

ฮาร์ดแวร์ที่ต้องเพิ่ม

บอร์ด DevKitC-1 ที่ใช้อยู่ ไม่มีขั้วต่อกล้อง — ต้องใช้บอร์ดที่มีกล้องแยก

ตัวเลือก | จุดเด่น
XIAO ESP32S3 Sense (แนะนำ) | กล้อง + 8MB PSRAM + ช่อง microSD (เก็บรูปหลายร้อยใบได้)
ESP32-S3 N16R8 CAM | สเปกใกล้บอร์ดเดิม แต่ไม่มีช่อง SD

ราคาราว 450–700 บาท · ซื้อ 1–2 ตัวก็พอ ใช้เป็นชุดต้นแบบ

ช่อง microSD สำคัญมาก
เก็บชุดข้อมูลต้องใช้รูปหลายร้อยใบ ถ้าไม่มี SD ต้องส่งผ่าน WiFi ทีละใบ ช้ามาก

กับดักที่พลาดกันบ่อยที่สุด

- แสงต้องคงที่!
  - ถ้าแสงเปลี่ยน โมเดลจะเรียน "แสง" แทน "ความสุก" — ต้องมีไฟ LED ในกล่อง + ระยะกล้องคงที่
- ต้องมีรูปพอ
  - อย่างน้อย 100–200 รูปต่อคลาส และต้องมีมะม่วงหลายลูก ไม่ใช่ลูกเดียวถ่าย 200 ครั้ง
- แยกชุดทดสอบไว้ต่างหาก
  - ถ้าเทสต์ด้วยรูปที่เทรน จะได้ 99% แบบหลอกตัวเอง

เส้นทางนี้ต่อยอดไปสู่: คัดเกรดมะม่วงส่งออก · ลดขยะอาหาร · แอปมือถือถ่ายรูปเช็คความสุก

## Slide 21

ก่อนขึ้นเวที

เคล็ดลับนำเสนอให้กรรมการประทับใจ

โชว์กราฟจริง

กราฟ VOC/สีที่ค่อย ๆ เปลี่ยน เล่าเรื่องได้ดีกว่าตัวเลขนิ่ง ๆ

ชูความสัมพันธ์เหตุ-ผล

เล่าว่าเอทิลีนสูง → สุกเร็ว ไม่ใช่แค่โชว์ตัวเลข

มี control เสมอ

กล่องเปรียบเทียบทำให้ผลน่าเชื่อถือ กรรมการชอบ

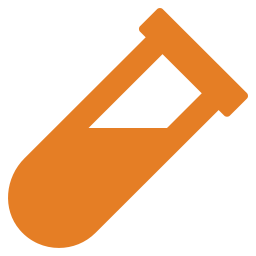
[picture p29: figure]

เชื่อมกับชีวิตจริง

ลดขยะอาหาร / คัดผลไม้ส่งออก — ตอบโจทย์สังคม

เดโมสด (ถ้าไหว)

เปิด Dashboard บนมือถือให้กรรมการดูค่าเรียลไทม์

บอกข้อจำกัดตรง ๆ

รู้ว่าอะไรยังไม่แม่น = โตทางวิชาการ กรรมการให้คะแนน

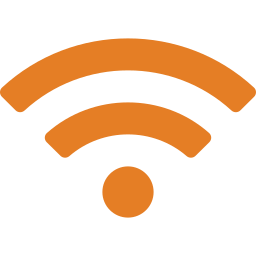
[picture p30: figure]

## Slide 22

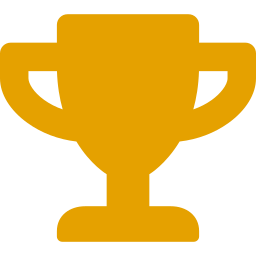
[picture p31: figure]

สรุปวันนี้

จากมะม่วงลูกหนึ่ง สู่ระบบเซ็นเซอร์ที่วัดได้จริง

เข้าใจวิทยาศาสตร์ของเอทิลีนและการสุก

ประกอบ ESP32 + เซ็นเซอร์บนบัส I2C ได้เอง

ใช้ได้ 2 โหมด: METER (คัดผลไม้) และ LAB (พิสูจน์เหตุ–ผล)

ออกแบบการทดลองและนำเสนอแบบมีหลักการ

ต่อยอด: เพิ่มกล้อง + TinyML ทำนายวันสุก (ข้อมูลติดป้ายเองจากเซ็นเซอร์) · คัดเกรดส่งออก · ลดขยะอาหาร
