SANCHAIE/mongobox/firmware/steps/README.md

# MangoBox — บันได 10 ขั้น (ทำทีละฟีเจอร์)

> **ปรัชญา:** ไม่แจกโค้ดก้อนใหญ่ให้แฟลชแล้วจบ — แต่ให้นักเรียน **สร้างทีละชั้น**
> แต่ละขั้นเพิ่มของใหม่ทีละอย่าง ทดสอบให้ผ่านก่อน แล้วค่อยไปขั้นถัดไป
> ทุกไฟล์มี **"ลองเล่นดู"** และ **"คำถาม"** ท้ายโค้ด — นั่นคือจุดที่การเรียนรู้เกิดขึ้นจริง

---

## ตารางบันได

| ขั้น | ชื่อ | ของใหม่ที่ได้เรียน | ผ่านเมื่อ... | เวลา |
|---|---|---|---|---|
| **1** | `step01_blink` | setup/loop, Serial, delay | LED กะพริบ + Serial มีข้อความ | 20 น. |
| **2** | `step02_i2c_scan` | บัส I2C, address | เจอครบ 4 ตัว: `0x29 0x3C 0x58 0x76` | 20 น. |
| **3** | `step03_bme280` | ไลบรารี, อ่านค่าเซ็นเซอร์ | เห็นอุณหภูมิ/ความชื้นใน Serial | 20 น. |
| **4** | `step04_oled` | วาดบนจอ, พิกัด x/y | จอโชว์อุณหภูมิตัวใหญ่ | 25 น. |
| **5** | `step05_color` | RGB → Hue, เขียนฟังก์ชันเอง | จ่อใบไม้ = %ต่ำ, จ่อของเหลือง = %สูง | 30 น. |
| **6** | `step06_gas` | TVOC, อุ่นเครื่อง, ชดเชยความชื้น | **ปิดกล่องมีกล้วย → ตัวเลขไต่ขึ้น!** | 40 น. |
| **7** | `step07_fan` | ทรานซิสเตอร์เป็นสวิตช์, ไดโอด | พัดลมหมุน 3 วิ หยุด 3 วิ | 25 น. |
| **8** | `step08_meter` | ถ่วงน้ำหนัก, ตัดสินใจจากข้อมูล | **เครื่องวัดความสุกใช้ได้จริง** | 35 น. |
| **9** | `step09_lab_mode` | ตัวแปรต้น-ตาม, NVS, ปุ่มกด | แยกเหตุ-ผล + กดปุ่มบันทึกได้ | 35 น. |
| **10** | `step10_dashboard` | WiFi, web server, JSON | เปิดดูค่าบนมือถือได้ | 30 น. |

**รวม ~4 ชั่วโมง 40 นาที** (พอดีกับ 6 ชม. เมื่อรวมพัก + อธิบายทฤษฎี + ทดลอง)

---

## แบ่ง Core / Stretch

ถ้าเวลาไม่พอ ให้ตัดตามนี้:

| | ขั้นที่ต้องได้ | เหตุผล |
|---|---|---|
| **Core (ต้องเสร็จ)** | 1 → 2 → 3 → 4 → 5 → 6 → 8 | ได้เครื่องวัดที่ใช้งานได้จริง + เห็นแก๊สขึ้นจริง |
| **Stretch (ถ้าทัน)** | 7 (พัดลม), 9 (โหมด LAB), 10 (WiFi) | ทำต่อที่โรงเรียนได้ |

> **ขั้นที่ห้ามข้าม: STEP 6** — เพราะเป็นขั้นเดียวที่นักเรียน "เห็นกับตา" ว่าผลไม้ปล่อยแก๊สจริง
> ถ้าข้ามขั้นนี้ ทั้งโปรเจกต์จะเหลือแค่ "วัดสี" ซึ่งไม่ตรงโจทย์

---

## เส้นทางของโค้ด (ต่อยอดขึ้นเรื่อย ๆ)

```
STEP 1  บอร์ดทำงาน
   ↓
STEP 2  เห็นเซ็นเซอร์บนสาย I2C
   ↓
STEP 3  + BME280 (อุณหภูมิ/ชื้น)
   ↓
STEP 4  + OLED  (มีจอแล้ว ไม่ต้องพึ่งคอม)
   ↓
STEP 5  + TCS34725 (สี → %ความสุก)
   ↓
STEP 6  + SGP30 (แก๊ส → เห็นเอทิลีนพุ่ง!)
   ↓
STEP 7  + พัดลม (สั่งงานโลกจริง)
   ↓
STEP 8  = METER : รวมทุกอย่าง → "กินได้หรือยัง?"
   ↓
STEP 9  = LAB   : แยกเหตุ-ผล → "เอทิลีนเร่งการสุกจริงไหม?"
   ↓
STEP 10 + WiFi  : โชว์กรรมการบนมือถือ
```

---

## เคล็ดลับสำหรับผู้สอน

1. **อย่าให้ข้ามขั้น** — ถ้าขั้นก่อนหน้าไม่ผ่าน ขั้นถัดไปจะพังแน่นอน และหาสาเหตุยากขึ้นเรื่อย ๆ
2. **ให้เวลากับ "ลองเล่นดู"** — โค้ดทุกไฟล์มีการทดลองท้ายไฟล์ เช่น ลบ `oled.display()` ออกแล้วดูว่าเกิดอะไร นี่คือจุดที่ความเข้าใจเกิด ไม่ใช่ตอนก๊อปโค้ด
3. **STEP 2 คือด่านหิน** — สายหลวมบนเบรดบอร์ดเป็นสาเหตุอันดับ 1 ของทุกปัญหา ให้ผ่านขั้นนี้ให้ได้ก่อนจริง ๆ
4. **STEP 6 เตรียมกล้วยสุกงอมไว้เยอะ ๆ** — เป็นตัวปล่อยเอทิลีนแรงที่สุด เห็นผลใน 10–20 นาที ถ้าใช้มะม่วงอย่างเดียวอาจรอนานเกินคาบเรียน
5. **เก็บโค้ดเต็มไว้เป็นตาข่ายกันตก** — ถ้ากลุ่มไหนตามไม่ทัน ให้แฟลช `mango_ripeness_esp32.ino` (โค้ดเต็ม 2 โหมด) แทน จะได้ไม่หลุดจากกิจกรรม

---

## ไฟล์โค้ดเต็ม (ตาข่ายกันตก)

`../mango_ripeness_esp32/mango_ripeness_esp32.ino` = ทุกอย่างรวมกัน + สลับโหมด METER/LAB ด้วยปุ่ม BOOT
ใช้เมื่อ: กลุ่มตามไม่ทัน / ต้องการชุดสมบูรณ์ไว้เก็บข้อมูลข้ามวัน / ตอนไปแข่งจริง
