SANCHAIE/mongobox/hardware/MangoBox_Wiring_Diagram.png

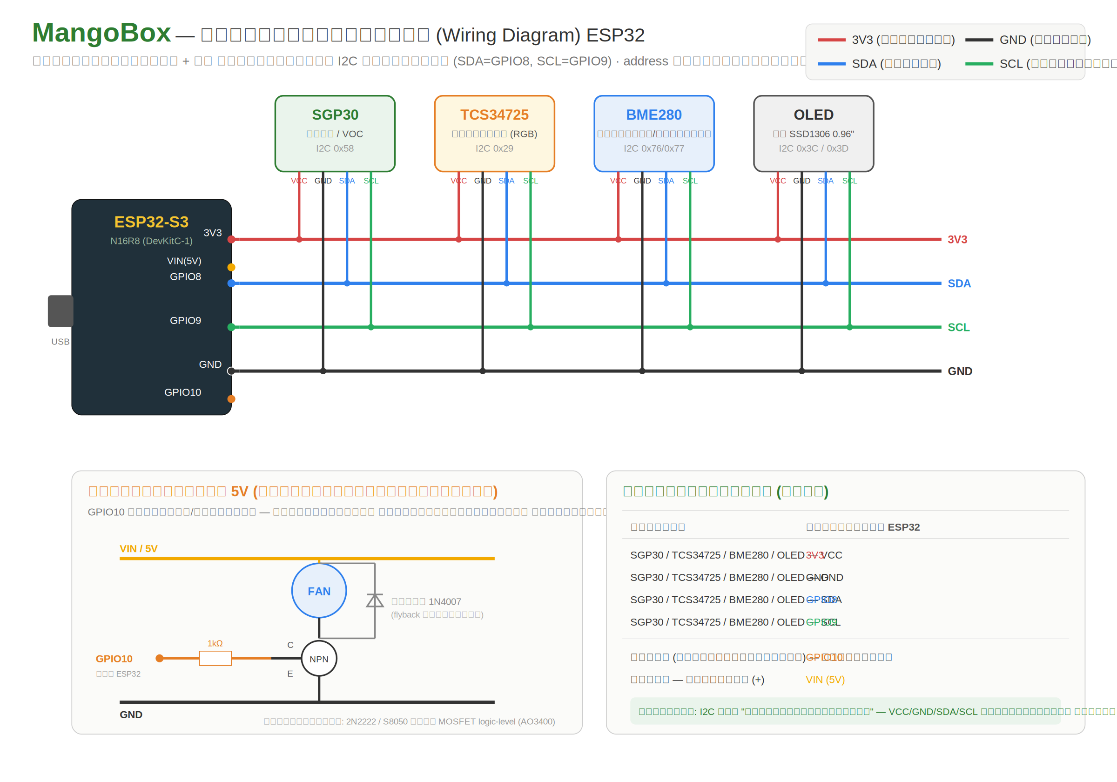
hardware/MangoBox_Wiring_Diagram.png
