SANCHAIE/mongobox/(commit log)

2026-07-13 MangoBox: ESP32-S3 ethylene sensor workshop for Burapha x Phlutaluang
    [MangoBox_BOM.xlsx]
2026-07-13 Implement color web dashboard for ESP32S3
    Add color dashboard functionality with calibration and RGB display.
